harris-newsteder/0000000001/media/P1.png

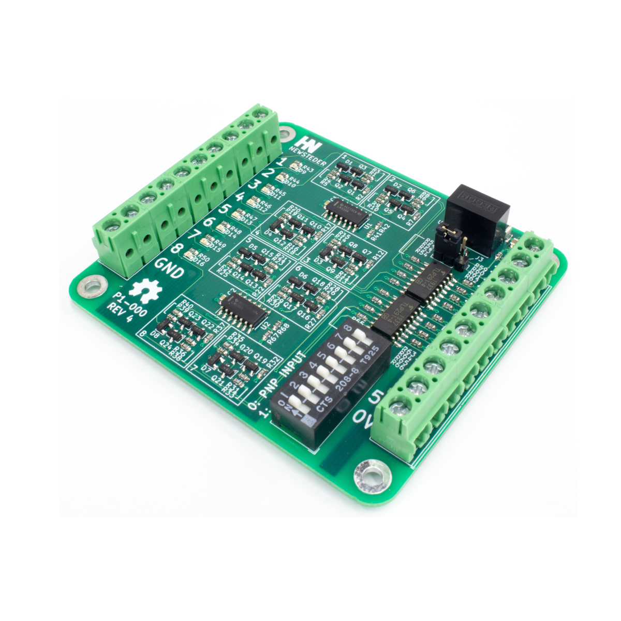
media/P1.png
