harris-newsteder/0000000001/media/000.png

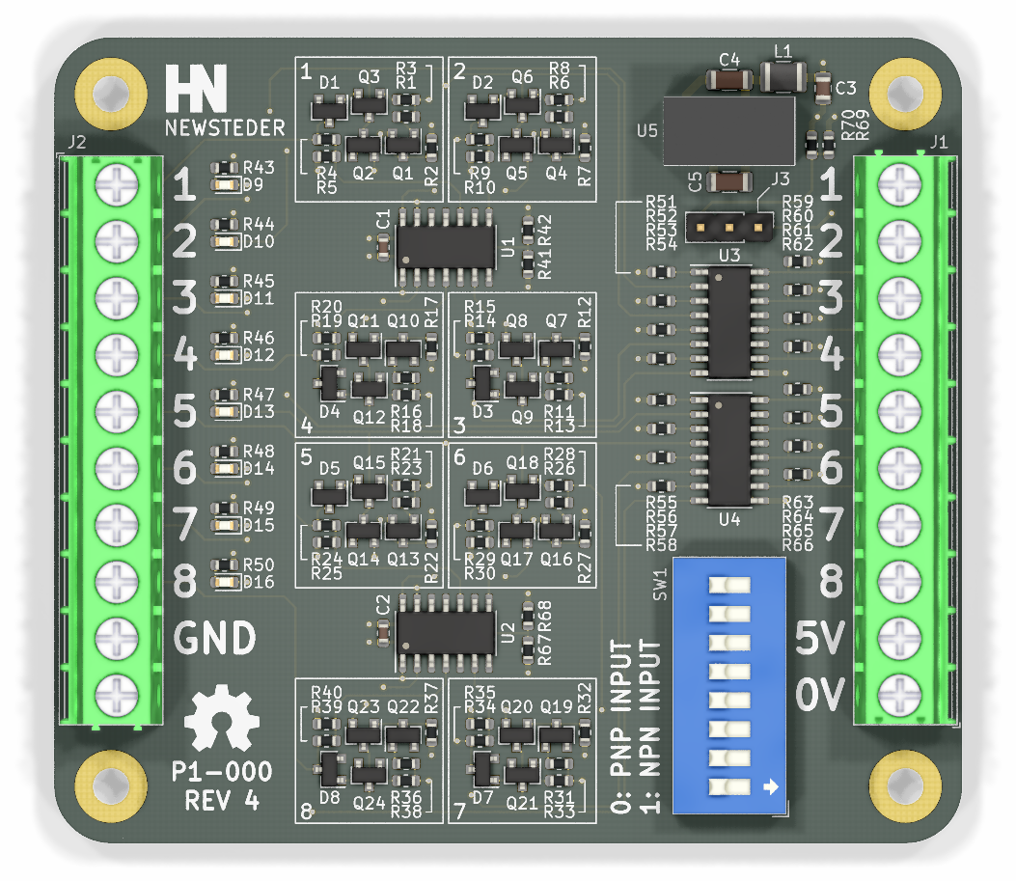
media/000.png
