harris-newsteder/0000000001/doc/P1-000 SCHEMATIC.PDF

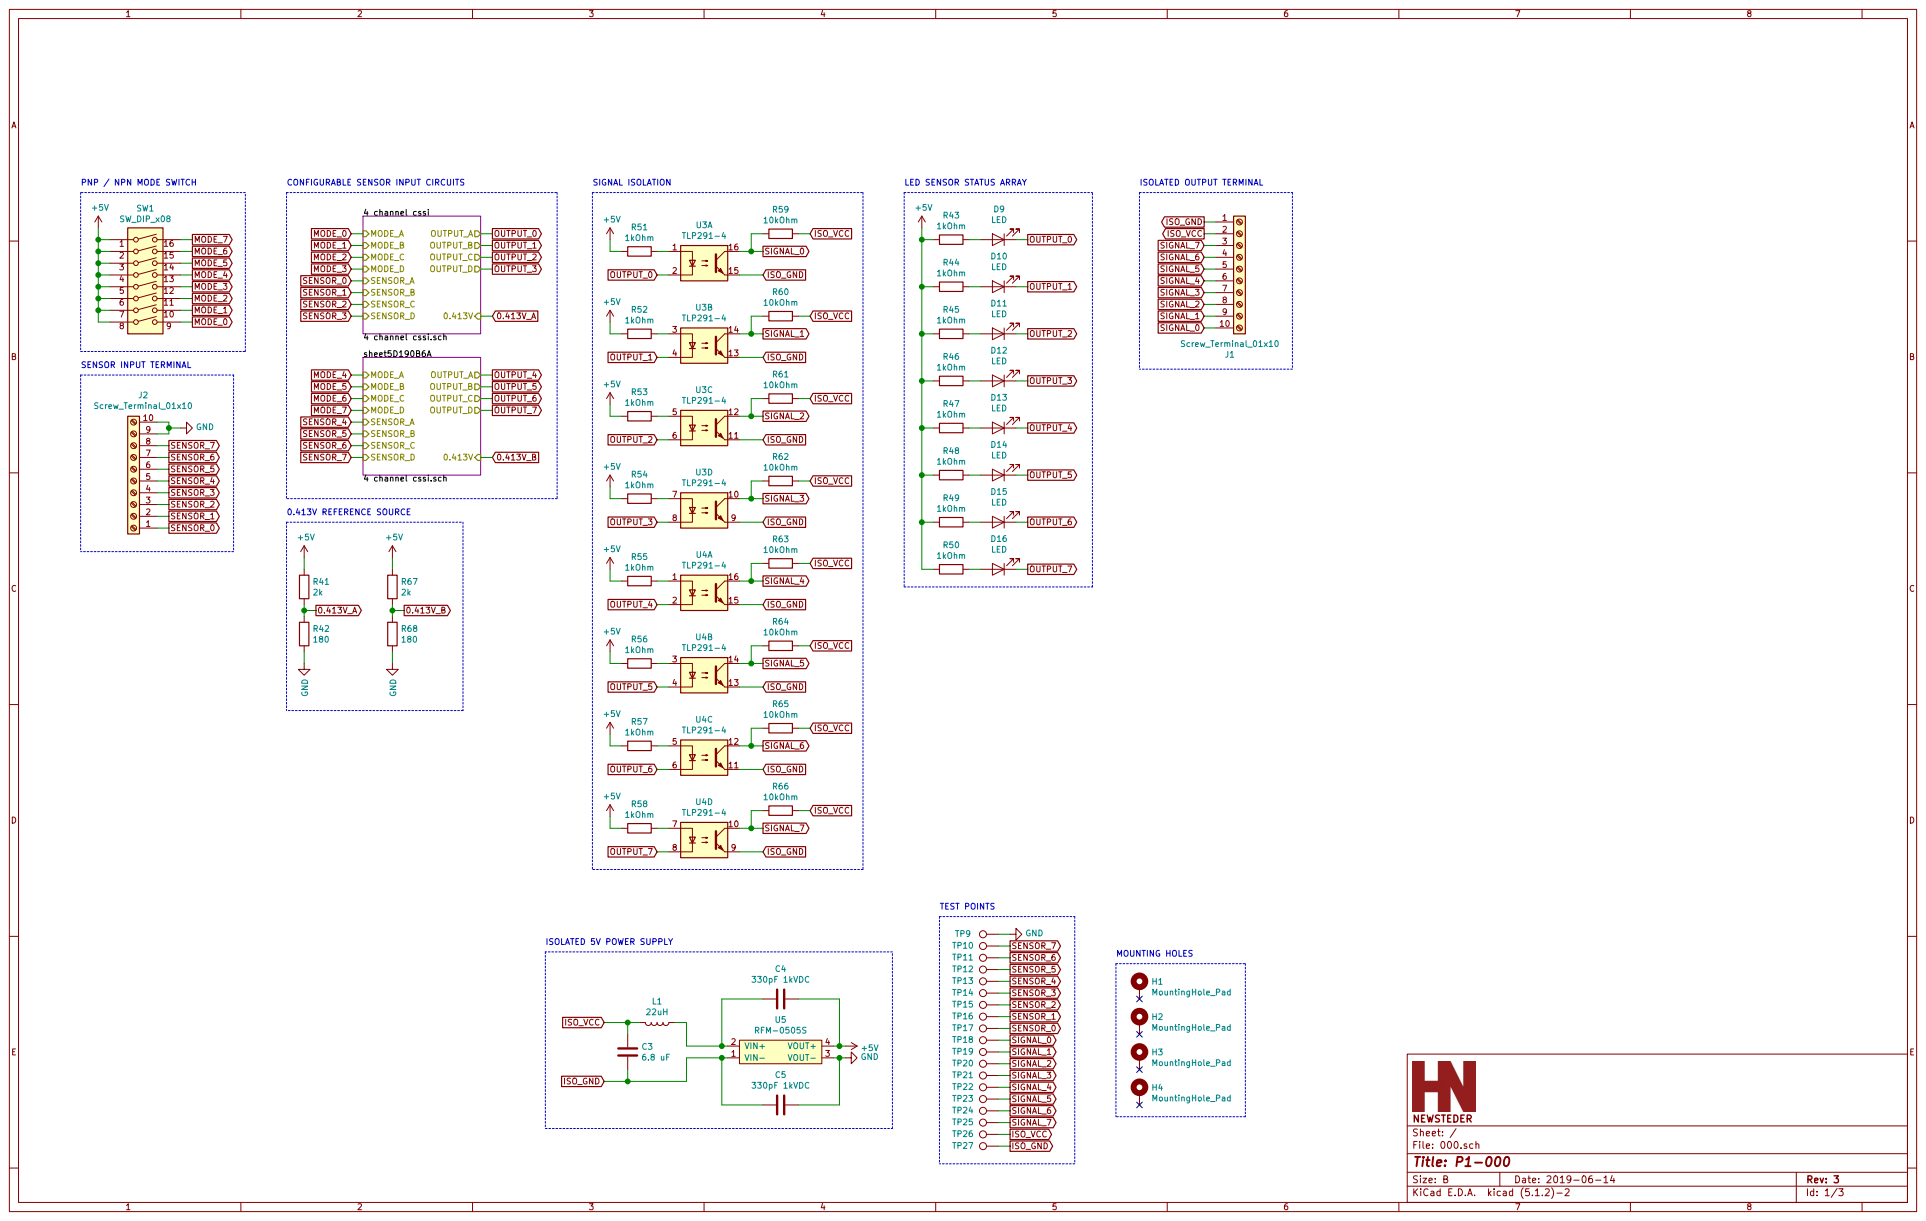
[picture p3: page 1]

PNP / NPN MODE SWITCH

4 channel cssi 4 channel cssi.sch MODE_A

File: 000.sch Sheet: / NEWSTEDER 1

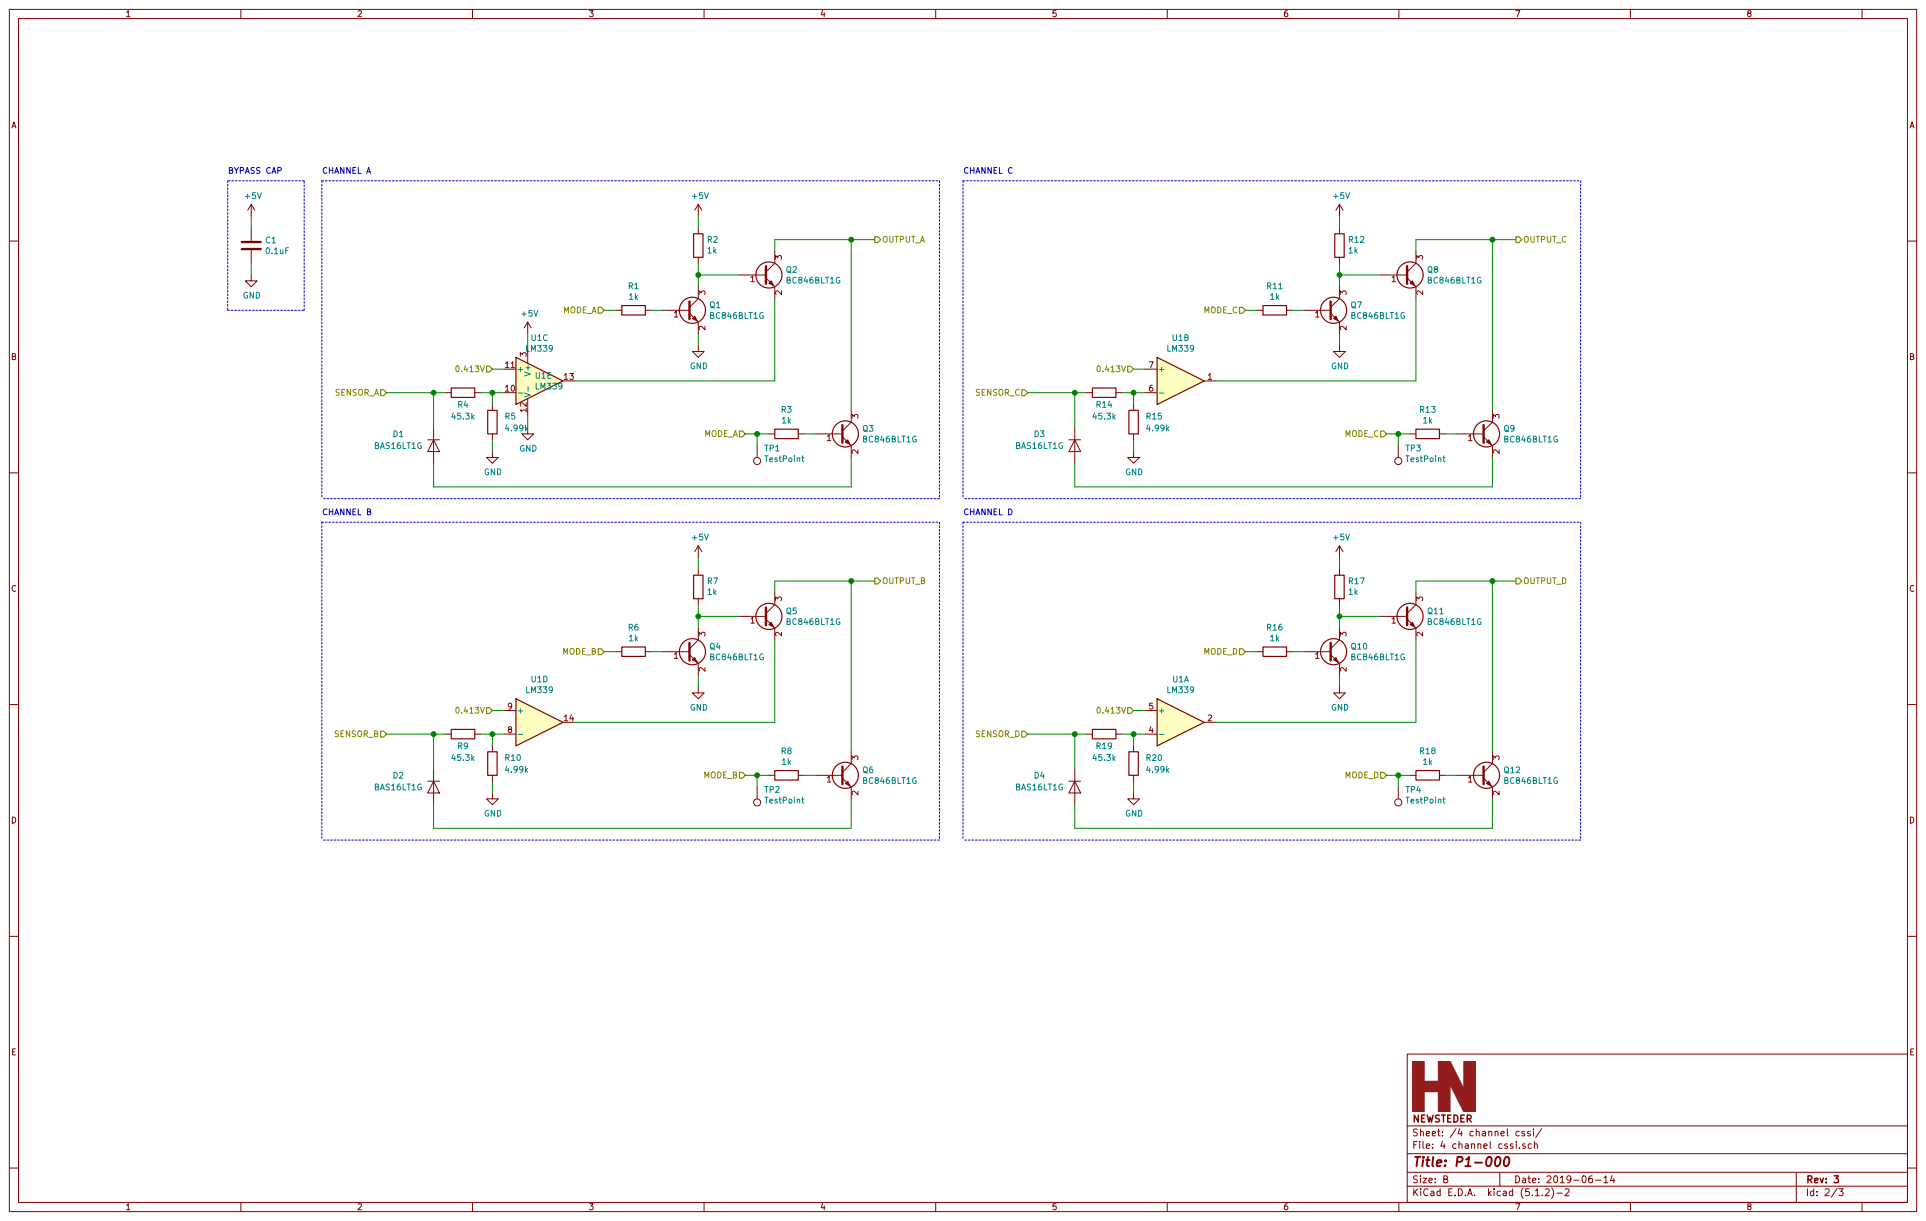
[picture p4: page 2]

File: 4 channel cssi.sch Sheet: /4 channel cssi/ NEWSTEDER

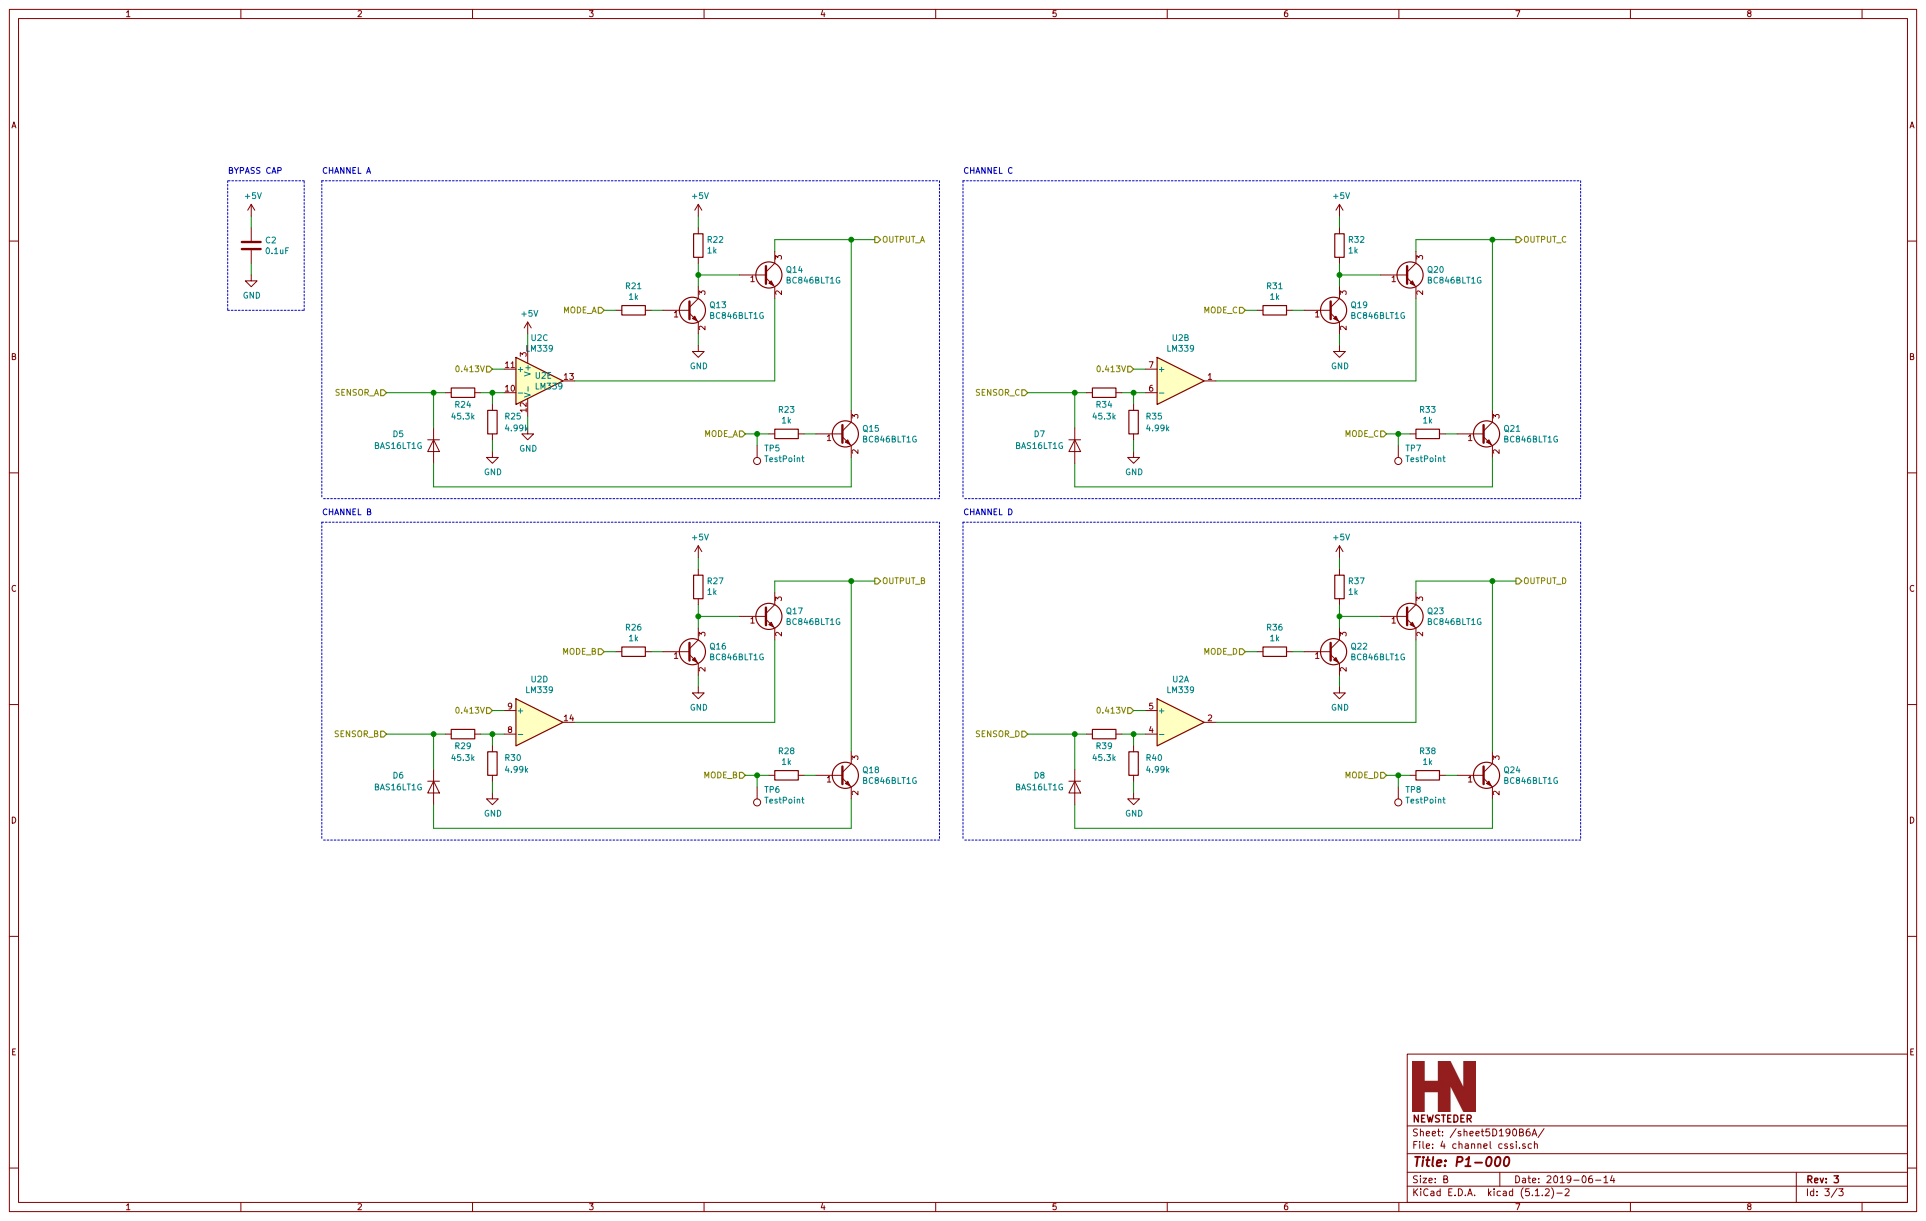
[picture p5: page 3]

File: 4 channel cssi.sch Sheet: /sheet5D190B6A/ NEWSTEDER
