harris-newsteder/0000000001/pcb/000/000.kicad_pcb

## KiCad design pcb/000/000.kicad_pcb (2020-01-20)

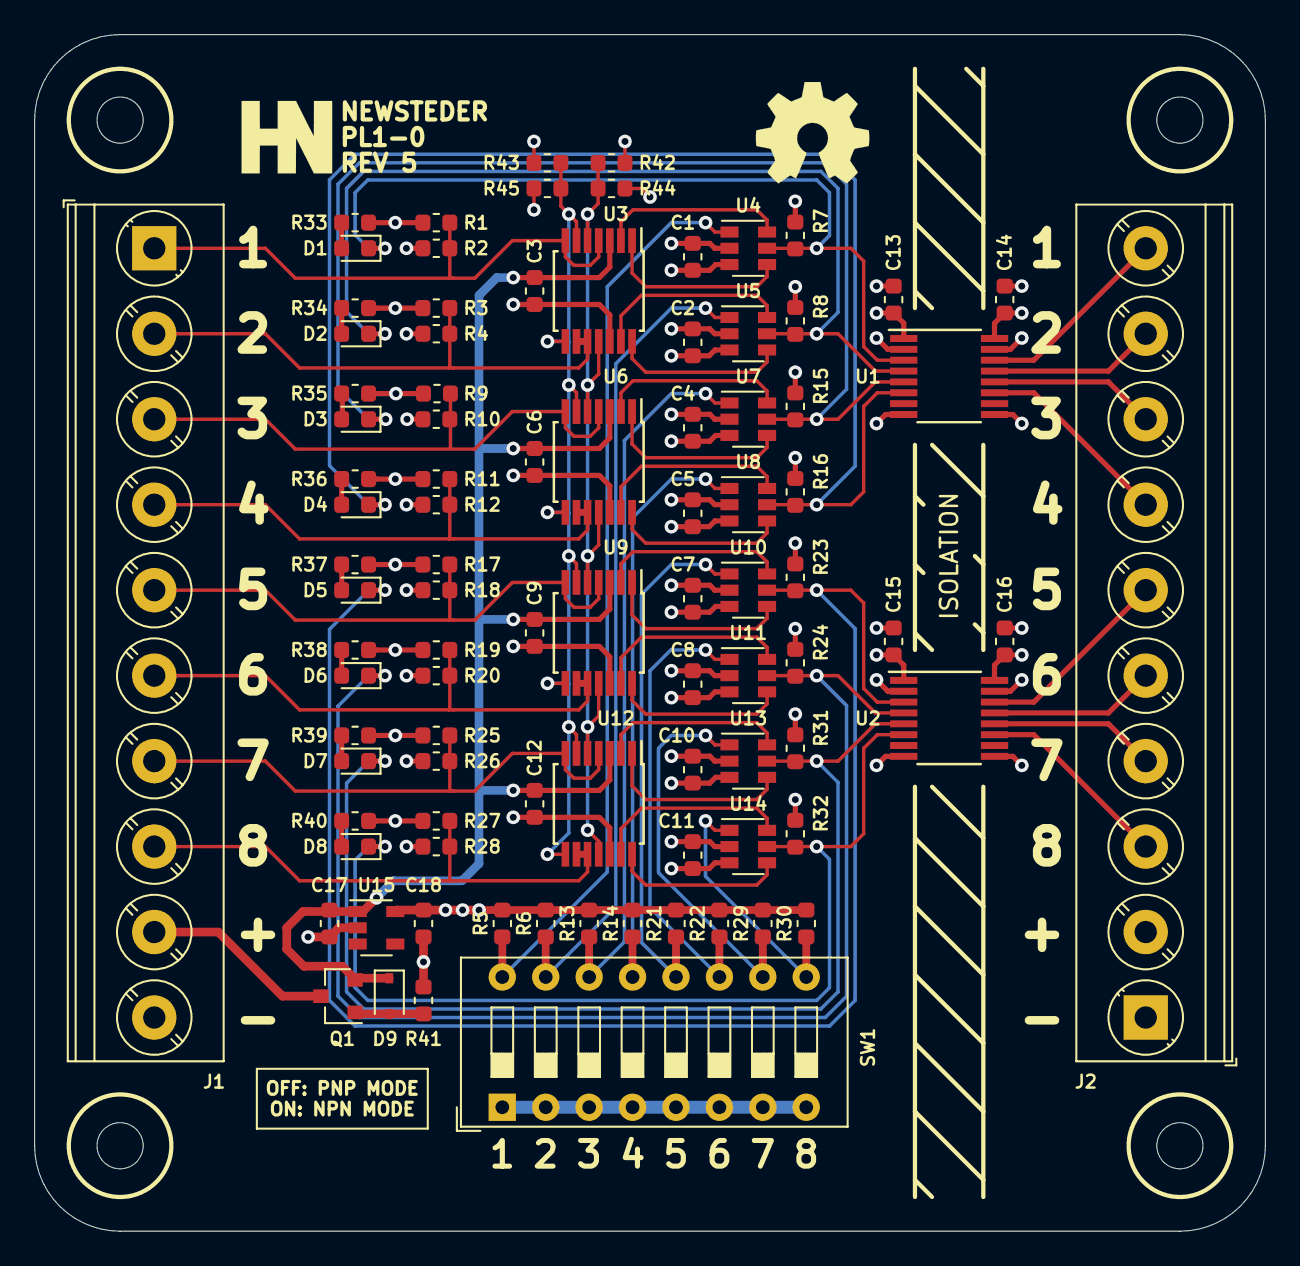
[picture p6: board 000.kicad_pcb from above]

Board: 4 copper layers, 72.0 x 70.0 mm, 91 parts (0 on the bottom side), 65 nets.

Parts:
C1, C2, C3, C4, C5, C6, C7, C8, C9, C10, C11, C12: 0.1uF; C_0603_1608Metric
C13, C14, C15, C16: C; C_0603_1608Metric
C17: 1.0uF; C_0603_1608Metric
C18: 1.5uF; C_0603_1608Metric
D1, D2, D3, D4, D5, D6, D7, D8: LED; LED_0603_1608Metric
D9: MM3Z10VT1G; D_SOD-323
J1: INPUT TERMINAL; TerminalBlock_Phoenix_PT-1,5-10-5.0-H_1x10_P5.00mm_Horizont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
J2: OUTPUT TERMINAL; TerminalBlock_Phoenix_PT-1,5-10-5.0-H_1x10_P5.00mm_Horizont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
Q1: ZXMP10A13FTA; SOT-23
R1, R2, R3, R4, R5, R6, R7, R8, R9, R10, R11, R12, R13, R14, R15, R16, R17, R18, R19, R20, R21, R22, R23, R24, R25, R26, R27, R28, R29, R30, R31, R32, R43, R44: 10kOhm; R_0603_1608Metric
R33, R34, R35, R36, R37, R38, R39, R40: 1kOhm; R_0603_1608Metric
R41: 100kOhm; R_0603_1608Metric
R42, R45: 6.65kOhm; R_0603_1608Metric
SW1: MODE SELECT SWITCH; SW_DIP_SPSTx08_Slide_9.78x22.5mm_W7.62mm_P2.54mm
U1, U2: Si8645BA-B-IU; QSOP-16_3.9x4.9mm_P0.635mm
U3, U6, U9, U12: LM339; TSSOP-14_4.4x5mm_P0.65mm
U4, U5, U7, U8, U10, U11, U13, U14: STG719STR; SOT-23-6
U15: TPS70950DBVR; SOT-23-5

Connections:
2.0V: R43.2, R45.1, U3.6, U3.8, U6.6, U6.8, U9.6, U9.8, U12.6, U12.8
3.0V: R42.2, R44.1, U3.5, U3.11, U6.5, U6.11, U9.5, U9.11, U12.5, U12.11
+5V: C1.1, C2.1, C4.1, C5.1, C7.1, C8.1, C10.1, C11.1, C13.2, C15.2, C18.1, R1.1, R3.1, R5.1, R6.1, R7.1, R8.1, R9.1, R11.1, R13.1, R14.1, R15.1, R16.1, R17.1, R19.1, R21.1, R22.1, R23.1, R24.1, R25.1, R27.1, R29.1, R30.1, R31.1, R32.1, R33.1, R34.1, R35.1, R36.1, R37.1, R38.1, R39.1, R40.1, R42.1, R43.1, U1.1, U2.1, U4.2, U5.2, U7.2, U8.2, U10.2, U11.2, U13.2, U14.2, U15.5
+VDC: C3.1, C6.1, C9.1, C12.1, C17.1, D9.1, Q1.2, U3.3, U6.3, U9.3, U12.3, U15.1
/OUT_0: J2.10, U1.14
/OUT_1: J2.9, U1.13
/OUT_2: J2.8, U1.12
/OUT_3: J2.7, U1.11
/OUT_4: J2.6, U2.14
/OUT_5: J2.5, U2.13
/OUT_6: J2.4, U2.12
/OUT_7: J2.3, U2.11
/SIG_0: J1.1, R1.2, R2.1, U3.4, U3.7
/SIG_1: J1.2, R3.2, R4.1, U3.9, U3.10
/SIG_2: J1.3, R9.2, R10.1, U6.4, U6.7
/SIG_3: J1.4, R11.2, R12.1, U6.9, U6.10
/SIG_4: J1.5, R17.2, R18.1, U9.4, U9.7
/SIG_5: J1.6, R19.2, R20.1, U9.9, U9.10
/SIG_6: J1.7, R25.2, R26.1, U12.4, U12.7
/SIG_7: J1.8, R27.2, R28.1, U12.9, U12.10
/UOUT_0: D1.1, R7.2, U1.3, U4.5
/UOUT_1: D2.1, R8.2, U1.4, U5.5
/UOUT_2: D3.1, R15.2, U1.5, U7.5
/UOUT_3: D4.1, R16.2, U1.6, U8.5
/UOUT_5: D5.1, R23.2, U2.3, U10.5
/UOUT_6: D6.1, R24.2, U2.4, U11.5
/UOUT_7: D7.1, R31.2, U2.5, U13.5
/UOUT_8: D8.1, R32.2, U2.6, U14.5
GND: C1.2, C2.2, C3.2, C4.2, C5.2, C6.2, C7.2, C8.2, C9.2, C10.2, C11.2, C12.2, C13.1, C15.1, C17.2, C18.2, J1.10, R2.2, R4.2, R10.2, R12.2, R18.2, R20.2, R26.2, R28.2, R41.2, R44.2, R45.2, SW1.1, SW1.2, SW1.3, SW1.4, SW1.5, SW1.6, SW1.7, SW1.8, U1.2, U1.8, U2.2, U2.8, U3.12, U4.3, U5.3, U6.12, U7.3, U8.3, U9.12, U10.3, U11.3, U12.12, U13.3, U14.3, U15.2
LV+: C14.2, C16.2, J2.2, U1.16, U2.16
LV-: C14.1, C16.1, J2.1, U1.9, U1.15, U2.9, U2.15
MODE_0: R5.2, SW1.16, U4.1
MODE_1: R6.2, SW1.15, U5.1
MODE_2: R13.2, SW1.14, U7.1
MODE_3: R14.2, SW1.13, U8.1
MODE_4: R21.2, SW1.12, U10.1
MODE_5: R22.2, SW1.11, U11.1
MODE_6: R29.2, SW1.10, U13.1
MODE_7: R30.2, SW1.9, U14.1
unnamed: D1.2, R33.2
unnamed: D2.2, R34.2
unnamed: D3.2, R35.2
unnamed: D4.2, R36.2
unnamed: D5.2, R37.2
unnamed: D6.2, R38.2
unnamed: D7.2, R39.2
unnamed: D8.2, R40.2
unnamed: D9.2, Q1.1, R41.1
unnamed: U3.1, U4.4
unnamed: U3.2, U4.6
unnamed: U3.13, U5.6
unnamed: U3.14, U5.4
unnamed: U6.1, U7.4
unnamed: U6.2, U7.6
unnamed: U6.13, U8.6
unnamed: U6.14, U8.4
unnamed: U9.1, U10.4
unnamed: U9.2, U10.6
unnamed: U9.14, U11.4
unnamed: U9.13, U11.6
unnamed: U12.1, U13.4
unnamed: U12.2, U13.6
unnamed: U12.13, U14.6
unnamed: U12.14, U14.4
VIN: J1.9, Q1.3
