harris-newsteder/0000000001/(commit log)

2019-12-22 rev 4 commit, works but uses a lot of power. commiting this change before going over to the new design
    [000.kicad_pcb, 000.sch, 4 channel cssi.sch]
2020-01-20 REV 5 of the board, much better power consumption and reponse time but the LDO is no good, only barely works and when you hook up an ammeter it blows the fuck up
    [000.kicad_pcb, 000.sch, 2 CHANNEL CSSI.sch, 2 channel ssinput.sch, 4 channel cssi.sch, CSSI.sch]
